Aimini/51cpu/document/采购-list.xlsx

名称 | 型号 | 数量
555定时器 | TLC555CP | 6 | 1 | Po
双掷开关 | DIP封装即可 | 4 | 1 | Tels
指拨开关 | 8位 DIP封装 | 4 | 1
杜邦线公对公 8P | DIP封装即可 | 20
自锁按钮 |  | 6 | 1
自复位按钮 |  | 7 | 1
LED 红色 |  | 10 | 1
8段光条管 红色 |  | 40 | 1 | 上海伟嘉电子A185
8段光条管 黄色 |  | 8 | 1
4.7k 8位排阻 |  | 48 | 1
4.7k电阻 |  | 50 | 1
1K电阻 |  | 20 | 1
100K电阻 |  | 10 | 1
680 电阻 |  | 10 | 1
330 电阻 |  | 10 | 1
1nF 电容 |  | 10 | 1
100pF 电容 |  | 10 | 1
1uF电容 |  | 10 | 1
30 电阻 |  | 10 |  | 优铄信数码专营店 (https://ysxsm.tmall.com/?spm=a1z10.3-b.1997427721.d4918089.5bfb70f7xyf3wJ)
七段数码管 红色 |  | 12 | 1
1M 电位器 | 3296W-1-105LF | 2 | 1
Arduino nano | DIP封装即可 | 2
6史密斯反相器 | 74LS14 | 1 | 1 | polouta数码旗舰店
2Kx8 SRAM | IDT6116SA35TP | 2 | 1
8Kx8 eeprom | AT28C64B-15PI | 15 | 1
4位寄存器 | 74LS173 | 22 |  | ：东莞赛格电子商行
8位三态输出缓冲器 | 74LS541 | 28 | 1
四个与门 | 74LS08 | 12 | 1
四个或门 | 74LS32 | 10 | 1
四位双向位移寄存器 | 74LS194 | 15 | 1
4位算数单元(ALU) | 74LS181 | 7 | 1
8选一选择器 | 74LS251 | 10 | 1
两个D锁存器 | 74LS74 | 6 |  | ：东莞赛格电子商行
双四选一选择器 | 74LS153 | 10 | 1
四或非门 | 74LS02 | 8 | 1
四与非门 | 74LS00 | 6 | 1
6非门 | 74LS04 | 11 | 1
奇偶校验器 | 74LS280 | 1 | 1
四二选一选择器 | 74LS157 | 7 | 1
4位加法器 | 74LS283 | 4 | 1
4位计数器 | 74LS161 | 7 | 1
8位双向总线三态门 | 74LS245 | 12 | 1
四异或门 | 74LS386 | 3 |  | ：东莞赛格电子商行
8位锁存器 | 74LS374 | 1 | 1
4位锁存器 | 74LS379 | 2 | 1
8输入或非门 | 74HC4078 | 1 | 1
4位比较器 | 74LS85 | 4 | 1
四二选一选择器 | 74LS257 | 4 |  | ：东莞赛格电子商行
8位双向移位寄存器 | 74198 | 6 | 1
4位锁存器 | 74LS171 | 1 | 1
缓冲器 | 7407 | 2 | 1
面包板 | 800孔即可 | 20
导线 | 和面包板同孔径 | 红黄蓝白各10米
稳压电源 | 5V输出即可 | 1
有源晶振 | 1 | 2 | 1
