Aimini/51cpu/document/采购.xlsx

名称 | 型号 | 数量 | 用途
555定时器 | TLC555CP | 6 | 手动时钟 | 时钟切换 | 自动停止选择 | 下一条指令
双掷开关 | DIP封装即可 | 4 | 时钟切换
指拨开关 | 8位 DIP封装 | 4 | 自动停止的周期
杜邦线公对公 8P | DIP封装即可 | 20
自锁按钮 |  | 6 | 自动停止选择 | 中断1 | 中断2
自复位按钮 |  | 7 | 重置 | 中断1 | 中断2 | 手动时钟 | 下一条指令
LED 红色 |  | 10 | 4+4 MIC和ISR
8段光条管 红色 |  | 40 | 11x8数据总线 | 4x16ALU总线 | 3x16地址总线 | 9x8 控制信号
8段光条管 黄色 |  | 8 | 8数据总线 | 16ALU总线 | 16地址总线
4.7k 8位排阻 |  | 48 | 11+1数据总线 | 8+2ALU总线 | 6+2地址总线 | 9控制总线
4.7k电阻 |  | 50 | 50上拉/下拉电阻
1K电阻 |  | 20
100K电阻 |  | 4
680 电阻 |  | 4
360 电阻 |  | 5
1nF 电容 |  | 6 | 时钟
100pF 电容 |  | 4
1uF电容 |  | 4 | 手动时钟
10pf 电容 |  | 4 | sram写入x1 | 中断上升沿检查x2
七段数码管 红色 |  | 12
电位器 | 3296W-1-105LF | 2
Arduino nano | DIP封装即可 | 2
6史密斯反相器 | 74S14 | 1
2Kx8 SRAM | IDT6116SA15TP | 2
8Kx8 eeprom | AT28C64B-15PU | 15
4位寄存器 | 74LS173 | 22
8位三态输出缓冲器 | 74LS541 | 28
四个与门 | 74LS08 | 12
四个或门 | 74LS32 | 10
四位双向位移寄存器 | 74LS194 | 15
4位算数单元(ALU) | 74LS181 | 7
8选一选择器 | 74LS251 | 10
两个D锁存器 | 74LS74 | 6
双四选一选择器 | 74LS153 | 10
四或非门 | 74LS02 | 8
四与非门 | 74LS00 | 6
6非门 | 74LS04 | 11
奇偶校验器 | 74LS280 | 1
四二选一选择器 | 74LS157 | 7
4位加法器 | 74LS283 | 4
4位计数器 | 74LS161 | 7
8位双向总线三态门 | 74LS245 | 12
四异或门 | 74LS386 | 3
8位锁存器 | 74LS374 | 1
4位锁存器 | 74LS379 | 2
8输入或非门 | 74HC4078 | 1
4位比较器 | 74LS85 | 4
四二选一选择器 | 74LS257 | 4
8位双向移位寄存器 | 74198 | 6
4位锁存器 | 74LS171 | 1
缓冲器 | 7407 | 1
