Aimini/51cpu/(list of files, cad)

Other CAD files:
keil_51vm/STARTUP.OBJ
