Aimini/51cpu/(list of files, drawings)

Other design files:
51cpu.circ
51cpu.pdsprj
module_test/ALU-A-TEST.pdsprj
module_test/ALU-B-TEST.pdsprj
module_test/ALU-EXTEND.pdsprj
module_test/ALU.pdsprj
module_test/BusBufferTest.pdsprj
module_test/DEBUG-TEST.pdsprj
module_test/DPTR-TEST.pdsprj
module_test/IICycle.pdsprj
module_test/INT-IPri-Test.pdsprj
module_test/INT-IRR-TEST.pdsprj
module_test/INT-ISR-Test.pdsprj
module_test/integrate/2INT-Test.pdsprj
module_test/integrate/4INT-Test.pdsprj
module_test/integrate/ALU-TEST.pdsprj
module_test/integrate/INT-IE-IP-TEST.pdsprj
module_test/integrate/TMP-TEST.pdsprj
module_test/MMIOTest.pdsprj
module_test/P0-PORT.pdsprj
module_test/PC -TEST.pdsprj
module_test/PCTest.pdsprj
module_test/PSWTest.pdsprj
module_test/RAMTest.pdsprj
module_test/RegisterBankTest.pdsprj
module_test/SERIAL-TEST.pdsprj
module_test/ShiftRegister.pdsprj
module_test/TMP-BIT-OPERATION.pdsprj
module_test/TMP-BITADDRESS-DECODER.pdsprj
module_test/TMP-DA-TEST.pdsprj
module_test/TMP-REG-TEST.pdsprj
