Aimini/51cpu/(commit log)

2018-12-21 build 51 cpu
    [51cpu.pdsprj, RegisterBankTest.pdsprj]
2018-12-26 add test file ,Bus Buffer\PC\RAM
    [51cpu.pdsprj, BusBufferTest.pdsprj, PCTest.pdsprj, RAMTest.pdsprj]
2019-01-06 add ALU Test File
    [ALU-TEST.pdsprj, ALU-TMP1-TEST.pdsprj, ALU-TMP2-TEST.pdsprj, ALU-TMP3-TEST.pdsprj]
2019-01-08 add ALU Module TEST
    [ALU-M-TEST.pdsprj]
2019-01-08 alu temp retgister 1 H8L function fixed
    [ALU-TMP1-TEST.pdsprj]
2019-01-11 move alu to sub circuit
    [ALU-M-TEST.pdsprj, ALU-TEST.pdsprj]
2019-01-23 add interrupt test file(no test yet)
    [INTTest.pdsprj]
2019-01-31 ` IRQ output signal logic fix, ISR clear condition fix
    [INTTest.pdsprj]
2019-01-31 fix ISR clean problem
    [INTTest.pdsprj]
2019-02-07 interrupt's ISR test.
    [INT-ISR-Test.pdsprj]
2019-02-07 add Interrupt priority selection circuit
    [INT-IPri-Test.pdsprj]
2019-02-07 add text comment
    [INT-ISR-Test.pdsprj]
2019-02-09 add interrupt request register test
    [INT-IRR-TEST.pdsprj]
2019-02-09 support 4 interrupt now(compenent reduced)
    [INTTest.pdsprj]
2019-02-09 PSW test
    [ALU-TEST.pdsprj, PSWTest.pdsprj]
2019-02-19 MMIO control signal test
    [MMIOTest.pdsprj]
2019-02-19 add acc odd flag to PSW.0
    [PSWTest.pdsprj]
2019-02-19 add BIT flag for bit jump instructions
    [ALU-TMP3-TEST.pdsprj]
2019-02-26 Interrupt Cycle bin generate script
2019-02-27 rename instruction.py to InstructionGenerate.py; Reformat InterruptCycle.py
2019-02-27 auto genrate name to hex map; add print_info() to print name and hex info
2019-02-28 add Interrupt Cycle Module
    [IICycle.pdsprj]
2019-02-28 add zero check output
    [ALU-TMP3-TEST.pdsprj]
2019-02-28 Reserve two interrupts for the actual hardware
    [INTTest-2.pdsprj]
2019-03-01 Rename Register TMP1 to ALU_A,TMP2 to ALU_B,TMP3 To TMP
    [ALU-A-TEST.pdsprj, ALU-B-TEST.pdsprj, TMP-TEST.pdsprj]
2019-03-01 add shift register test file
    [ShiftRegister.pdsprj]
2019-03-02 refactor(InstructionGenerate.py):add function to generate final instrucions - add add_recount_and_interrupt_check(instructions), that generates a list of microinstructions with interrupt checking and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
2019-03-04 style:specification signal label - the label Reset(RST) for asynchronous clear. -label Clear(CLR) for synchronous clear
    [51cpu.pdsprj, ALU-A-TEST.pdsprj, ALU-B-TEST.pdsprj, BusBufferTest.pdsprj, IICycle.pdsprj, INT-IRR-TEST.pdsprj, INT-ISR-Test.pdsprj, INTTest-2.pdsprj]
2019-03-04 fix(ALU-M-TEST):simulate error fixed -exclude no model component from project.
    [ALU-M-TEST.pdsprj]
2019-03-06 feat:new ALU Data BUS - ALU_A is 16bit reg, two control singal, L8LE load lower 8 bit from bus H8LE load hight 8 bit for bus - ALU_B is 16bit shiftreg, has two control singal S0 S1 that same as 4 bit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
    [ALU-A-TEST.pdsprj, ALU-B-TEST.pdsprj, ALU-TEST.pdsprj]
2019-03-07 feat:using new bus desgin - change bus type - add lgoic probe in ALU data bus and address bus and component in these two bus
    [51cpu.pdsprj, ALU-B-TEST.pdsprj, ALU-TEST.pdsprj, BusBufferTest.pdsprj]
2019-03-07 feat:add new bit operation -add set 0 \set 1\invert\set as carry for bit operate mode - add carry and,carry or, current selected bit output for boolean output mode
    [TMP-TEST.pdsprj]
2019-03-07 feat: Carry bit can set separately - Carry bit can set independently when $FLAG$\CyOnly, $BUS$\FLAG, $FLAG_LE$ is 1.
    [PSWTest.pdsprj]
2019-03-08 feat:add extend alu function - support XCHD ,swap using ALU_A High 8 and Lower 8 bit. - support addr11 format, move fist byte (IR) to ALU_8 High 8 bit and second byte to Lower 8 bit. - support SWAP, 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
    [ALU-A-TEST.pdsprj, ALU-EXTEND.pdsprj, ALU-TEST.pdsprj]
2019-03-08 feat: add bit address latch - add bit address latch for bit operation - fix boolean ouput error( I.7 I.0)
    [TMP-BIT-OPERATION.pdsprj]
2019-03-08 feat:PSW add new input mode - PSW can keep OV\AC Flag value when load flag from ALU. - Carry flag support 8 inputs(CY0~CY7), 5 for external input(CY0~CY4), CY5 is 0, CY is 1,CY7 is invert of Carry. -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
    [PSWTest.pdsprj, TMP-BIT-OPERATION.pdsprj]
2019-03-09 feat:add DA \ bitaddress decoder - add DA component to support DA A instrcution - add BITADDRESS-DECODER to support bitaddressable ram.
    [TMP-BITADDRESS-DECODER.pdsprj, TMP-DA-TEST.pdsprj]
2019-03-09 refactor: TMP sub-module - TMP-REG storage temp data and provide shift function - TMP-BIT-OPERATION support bit and boolean operation.
    [TMP-BIT-OPERATION.pdsprj, TMP-REG-TEST.pdsprj]
2019-03-09 test: test intergrate of TMP reg and sub-module
    [TMP-TEST.pdsprj]
2019-03-09 style: wire layout changed
    [PSWTest.pdsprj]
2019-03-09 opt: interrrupt cycle cricuit optimization
    [IICycle.pdsprj]
2019-03-09 test: add interrupt and reg test - IE reg, provide 2 interrupt enable bit - IP reg, provide 2 interrupt priority bit - TCON reg, 2 of interrupt type control bit(bit.0 bit.2), 2 bit are integrate in i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
    [INT-TEST.pdsprj]
2019-03-09 test: integrate TMP and PSW - add TMP reg and sub-module - adjust PSW for MUL \DIV\ DA instrucion. Cy5 is DA_Carry Flag,Cy6 is TMP ZF,Cy7 is TMP /ZF
    [51cpu.pdsprj, PSWTest.pdsprj, TMP-TEST.pdsprj]
2019-03-10 fix: using async reset for microinstruction counter - register /ram need hold time after rasing edge, if reset MIC in the same cycle, Unpredictable errors will occur
    [IICycle.pdsprj]
2019-03-10 feat: add P0 port
    [P0-PORT.pdsprj]
2019-03-10 feat: add MMIO
    [51cpu.pdsprj]
2019-03-10 fix: empty subcircuit fixed - INTERRUPT subcircuit fixed - IR subcircuit fixed - add probe
    [51cpu.pdsprj]
2019-03-10 refactor: put reg bank to ram - reg bank are part of ram, RAR provide two address register, one is connect to data bus. Another register gets the address of register by decoding from PSW and IR.
    [RAMTest.pdsprj]
2019-03-11 opt: P0 MMIO control singal optimization - P0 is only controlled by MMIO，remove microinstruction in signal - P0 load signal is active high input.
    [51cpu.pdsprj, INT-TEST.pdsprj, P0-PORT.pdsprj, TMP-TEST.pdsprj]
2019-03-11 feat: add MMIO only reg's control signal
    [51cpu.pdsprj]
2019-03-11 feat: add all control label
    [51cpu.pdsprj]
2019-03-11 refactor: new control label for interrupt
2019-03-11 feat: add control label - add MINotFoundError, throw this error when can't found microinstruction label in InstructionControlSignal.create_instruction_bin_list. -when printing control singal label an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
2019-03-11 feat:change BIT-OPERATION work - add a latch to storage bit(Qn), now support 8 bit opeartion mode. -- 000 Qn -- 001 /Qn -- 010 1 -- 011 TMP.N -- 100 TMP_ZF -- 101 DA_CF -- 101 Qn or TMP.N -- 111 Qn a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
    [TMP-BIT-OPERATION.pdsprj]
2019-03-11 refactor: simplefiy PSW - now all bit operation (Carry and OV) or flag loading which not from ALU are move to BIT-OPERATION
    [PSWTest.pdsprj, TMP-BIT-OPERATION.pdsprj]
2019-03-11 feat: connect all control singal to component
    [51cpu.pdsprj]
2019-03-11 feat: add new control fuction - NEXT BYTE: send current PC value to PAR, PC increased at same time. - ALU_A_DBUS_L8E:ALU set lower 8 bit from data bus. - RAR-@Ri: @Ri index, read Ri's value and send 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
2019-03-12 feat: add CN+16 LE for ALU_A - ALU_A will load the result depend on CN+16 in Div, so Add CN+16 LE , when CN+16 is high,ALU_A will load Data from bus. - replace 74198 to 74ls194 in ALU reg, 74298 will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
    [ALU-A-TEST.pdsprj, ALU-TEST.pdsprj]
2019-03-12 feat: add CN+16 input for register shift input
    [TMP-REG-TEST.pdsprj, TMP-TEST.pdsprj]
2019-03-12 feat: use new ALU reg - using 74ls194 to replace 74198 in register ALU_A and ALU_B - add control signal ALU_A_CN16LE
    [51cpu.pdsprj, ALU-A-TEST.pdsprj, ALU-B-TEST.pdsprj, ALU-TEST.pdsprj]
2019-03-12 fix: MOV A,#immed bug fixed - PC replace BCD counter(74ls160) to 4 bit counter(74ls161) - INT_ADDR[0..4] internal connect fixed
    [51cpu.pdsprj]
2019-03-12 fix:RAR\RAM wrong label fixed -RAR correct O[0..7] to IO[0..7] - RAM correct ADDR[0..7] to A[0..7]
    [51cpu.pdsprj]
2019-03-12 fixed: fix tranceiver and ALU label - ADTRANSC change /ADT_H8E(duplicate) to /ADT_L8E -ALU add A[0..7] and B[0..7]
    [51cpu.pdsprj]
2019-03-12 fix: TCON can ouput now - connect TCON to correct bus line.
    [51cpu.pdsprj]
2019-03-12 fix: ALUEXT output contention fixed -In some cases, the upper 8 bits of the ALUEXT output contention. This is most likely a software bug. 774ls541 opened multiple in the correct input.After 74ls541 i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
    [51cpu.pdsprj, ALU-EXTEND.pdsprj]
2019-03-13 fix: RAM MMIO map bug fixed - it's might be software bug, when 2764(MMIO Decoder) OE is higt, it's also ouput a value. now using 74ls245 as a tristate output.
    [51cpu.pdsprj, MMIOTest.pdsprj]
2019-03-13 fix: remove wrong signal - PSW.0 is Parity bit,I confused it with ZF. - merge ACC_ZF and TMP_ZF,using TMP_ZF to Determine if ACC is 0
    [51cpu.pdsprj]
2019-03-13 feat: add AJMP instruction -beacause software bug ,replace 74ls257 to 74ls245. -add AJMP addr11(all) instruction
    [51cpu.pdsprj]
2019-03-13 feat: add LJMP implement -add instruction LJMP addr16(02)
    [51cpu.pdsprj]
2019-03-13 feat: INC A(sofware bug) - add INC A instrcution(04),beacuse of software bug, must add extrenal ALU to refreash the output value. otherwise ALU will output 0x0F at first INC.
    [51cpu.pdsprj]
2019-03-13 implement: INC direct instruction test passed - add input latch for ram, otherwirse ram will read zero in high frequency lock. - change RAM_LE to RAML_LATCH_LE for P0 MMIO.
    [51cpu.pdsprj]
2019-03-13 feat: add JBC bit,offset - add test file and generate code - fix BIT_OPEREATON /OE notwork problem
    [51cpu.pdsprj]
2019-03-14 feat: add next instruction control - now can excute instruction one by one, the excute process will paused when microinstruction counter become zero.
    [51cpu.pdsprj]
2019-03-14 fix: PSW Cy ALU FLAG input fix - correct PSW Carry Flag input terminal label(CY0 -> Cy)
    [51cpu.pdsprj]
2019-03-15 feat: add debug tools - stop on designated microinstruction step - stop on designated instruction counter(how much instruction excuted now)
    [DEBUG-TEST.pdsprj]
2019-03-15 fix: count one in zero - now counter added 1 when MIC become zero - add reset input
    [DEBUG-TEST.pdsprj]
2019-03-15 fix: instruction counter stop in correct position
    [DEBUG-TEST.pdsprj]
2019-03-15 feat: add isntruction debug to 51cpu -in debug mode -- control to stop at designated microinstruction step -- control to stop at designated instruction count -- control to excute to next instruction 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
    [51cpu.pdsprj, DEBUG-TEST.pdsprj]
2019-03-15 fix: dptr high 8bit can load now
    [51cpu.pdsprj]
2019-03-16 test: INC DPTR passed
    [51cpu.pdsprj]
2019-03-19 fix: DA A no carry error fixed - when A is great than 0xFA ,the low-order 4 bit will add 6 cause high- order 4bit carry out, this will also casuse high-order 4bit add 6 and set Carry Flag
    [51cpu.pdsprj]
2019-03-19 test:DA A passed
    [TMP-DA-TEST.pdsprj]
2019-03-21 feat:Add HALT control - when HALT is 1, the clock will be stoped, and when NEXT is 1, clock will resume.
    [DEBUG-TEST.pdsprj]
2019-03-21 feat: add the way that resume from halt using state machine to detect - MIC become zero edge - HALT rasing edge - MCLK rasing edge - NEXT rasing edge
    function
    - stop all clock output when HALT rasing edge
    - enable all clock output when MCLK or NEXT rasing edge
    - (stop debug clock)switch to MCLK(manual clock) when MIC(micro
    instruction counter) become zero
    - (start debug clock)switch to debug clock when NEXT rasing edge
    [DEBUG-TEST.pdsprj]
2019-03-21 feat:add HALT(0xA5) support
    [51cpu.pdsprj, DEBUG-TEST.pdsprj]
2019-03-24 feat(ALU_A_TEST): add more LOAD method add new input method for ALU_A,now using 3 bit input to control load form. mark 3 bit as S3S1S0: - 000: keep - 001 load low 8bit - 010 load high 8bit - 011 load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
    [ALU-A-TEST.pdsprj]
2019-03-24 test: ALU intergrate ALU_A test
    [ALU-A-TEST.pdsprj, ALU-TEST.pdsprj]
2019-03-24 feat(TMP_BOP):can clear carry bit(bit.7) Individually
    [TMP-BIT-OPERATION.pdsprj]
2019-03-24 feat: change TMP shfit bit input.1 to CN+16 for div
    [51cpu.pdsprj]
2019-03-24 feat: add BOP_CLR_CY sopport
    [51cpu.pdsprj]
2019-03-24 fix(51cpu):CN+16 input error fixed - change TMP shift input 1 to CN+16
    [51cpu.pdsprj]
2019-03-24 feat(PC): add new load method for PC PC support 8 load form now: 000 - keep 001 - load all 010 - load when ZF 011 - load when /ZF 100 - load when BITQ 101 - load when /BITQ 110 - load when Carry 111 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
    [PC -TEST.pdsprj]
2019-03-24 feat: using new PC load control signal
    [51cpu.pdsprj, DEBUG-TEST.pdsprj]
2019-03-24 fix: remove wrong inverter for PC_S0
    [51cpu.pdsprj]
2019-03-25 feat: add new ALU CN+0 input control - for SUBB and ADDC instruction , add new CN+0 control: 00: 0 01: 1 10: CY 11: /CY
    [51cpu.pdsprj]
2019-03-25 feat: remove flag input for IR decoder(eeprom)
    [51cpu.pdsprj, ALU-A-TEST.pdsprj]
2019-03-25 refactor: move function to inuntil.py - move print_mi_map \ write_as_bin\ write_part_of_instruction to inuntil .py - move print_mi_map parameter startcounter to the last position, add default value 0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
2019-03-25 fix:Interrupt cycle indicator latch's clock error repair
    [51cpu.pdsprj]
2019-03-25 fix: clear MIC when IC end Because interrupt cycle indicator latch will cleared in rasing edge but counter load zero when falling edge, so add a latch to store the load zero signal for one clock long.
    [51cpu.pdsprj]
2019-03-25 opt:follow previous submit
    [51cpu.pdsprj]
2019-03-25 fix: control singal bug fix - IRnQ(which int will accept) no output fix -INT_SVC_END default pull up to low
    [51cpu.pdsprj]
2019-03-26 opt:reduce BIT-OPERATION used compnent - use 1 of 8 selector to generate BITQ output - use eeprom to ouput bit opeartion( modify the specified bit)
    [TMP-BIT-OPERATION.pdsprj]
2019-03-26 opt: using new bit opeartion part
    [51cpu.pdsprj]
2019-03-26 opt:using eeprom to replace ISR logic
    [INTTest-2.pdsprj]
2019-03-26 opt: using eeprom to replace IPS logic
    [INTTest-2.pdsprj]
2019-03-27 fixed:correct READ-MODIFY-WRITE_BACK opeartion for P0 port
    [51cpu.pdsprj]
2019-03-28 feat:add DPTR 8 BIT IO function - ouput low-8bit to 8IO port - ouput high-8bit to 8IO port - load low-8bit from 8IO port - load high-8bit from 8IO port
    [DPTR-TEST.pdsprj]
2019-03-28 feat: SFR support DPL and DPH
    [MMIOTest.pdsprj]
2019-03-28 feat: intergate MMIO and DPTR
    [51cpu.pdsprj, INTTest-2.pdsprj]
2019-03-29 feat:add serial port - add register that storege a byte from bus. - transport the register's byte from serial port - add a flip flop to storage TI flag.
    [SERIAL-TEST.pdsprj]
2019-03-29 opt: update label name
    [SERIAL-TEST.pdsprj]
2019-03-29 feat: add SCON,TI sfr support
    [51cpu.pdsprj, MMIOTest.pdsprj]
2019-03-29 opt:using sync opeartion - set SEND_FLAG to 1 when CPU_CLK rasing and SBUFLE is 1 and COUNT_END is 0 - count and enumerate each bit to serial port - stop count when counter is 10 - clear SEND_FLAG an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
    [SERIAL-TEST.pdsprj, 采购-list.xlsx, 采购.xlsx]
2019-04-07 opt:merge interrupt to eeprom - using A12 to control Interrupt Cycle
    [51cpu.pdsprj]
2019-04-12 opt: change component for PCB
    [51cpu.pdsprj, MMIOTest.pdsprj, SERIAL-TEST.pdsprj]
2019-04-16 feat: add led to p0 port
    [51cpu.pdsprj]
2019-04-26 opt: using the 12MHZ clock to divide to the serial clock After the main clock divde by 1250, the serial receiving clock of 9600HZ is obtained.
    [51cpu.pdsprj]
2019-05-30 test!!: add bug catch cricuit - proteus bug (probably) cause ram load zero under small probability , I can't found the reason.
    [51cpu.pdsprj, INTTest-2.pdsprj]
2019-05-30 feat : using logisim to bulid it(I hate protues bug)
    [51cpu.circ]
2019-05-31 fixed: p0 port 7segment led replaced - in test program, we rorate right P0 in loop, but sometime P0 will become zero or inexplicably added one more bit.After a series of investigations, I found the 7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
    [51cpu.pdsprj]
2019-06-05 refactor: Organize folders - mov all signal test file (.pdsprj) to module_test -rename ALU_M-test.pdsprj to ALU.pdsprj - mov ALU-TEST INT-TEST INTTest-2.pdsprj to module_test/integrate
    [ALU-A-TEST.pdsprj, ALU-B-TEST.pdsprj, ALU-EXTEND.pdsprj, ALU-TEST.pdsprj, ALU.pdsprj, BusBufferTest.pdsprj, DEBUG-TEST.pdsprj, DPTR-TEST.pdsprj]
2019-06-05 feat: add ardunio program that write LUT to eeprom bacause we have large of eeprom LUT file like instruction-0.bin to instrunction-9.bin, we need write a lot of program to flash eeprom with same proc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
2019-06-05 refactor: more cleared name
    [2INT-Test.pdsprj, 4INT-Test.pdsprj, INT-IE-IP-TEST.pdsprj]
2019-06-09 fixed: change PC and DPTR to 16 bit - some instructions test passed: *0x06 INC @R0 *0x08 INC Rn *0x10 JBC bit *0xD5 DJNZ direct,offset
    [STARTUP.OBJ, pcb检查.xlsx]
2019-06-10 feat : 0x32-RETI and interrupt supported - add property interrupt_end_linstener to store callback function - add function start_interrupt to enter interrupt service(not implement yet) .
2019-06-11 feat:0x53-ANL direct,#immed supported
    [STARTUP.OBJ]
2019-06-11 feat:0x62-XRL direct,A supported
    [STARTUP.OBJ]
2019-06-12 feat:0xE8:MOV A,Rn supported
    [STARTUP.OBJ]
2019-06-12 feat:0x92-MOV bit,C supported
    [STARTUP.OBJ]
2019-06-12 feat:0x95-SUBB A,direct supported
    [STARTUP.OBJ]
2019-06-13 feat: add start/pause/stop and clear terminal button
2019-06-14 opt:improve performance - using requestAnimationFrame to find changed value in each frame and rerender the dom instead of using callback to change dom when value changed
2019-11-15 opt: micro instruction counter using sync clear - MICR signal , cause micro instruction counter load zero synchronously now . when instruction end or enter interrupt cycle -ICE leave interrupt cycle 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
    [51cpu.pdsprj]
2019-11-15 fix: interrupt cycle micro instruction counter should reset to 0 at last operation
